aaronjonesii/CustomKeyboard/README.md

# CustomKeyboard
 Full Custom Mechanical Keyboard
