aaronjonesii/CustomKeyboard/KeyboardPCB/keyboard-layout.png

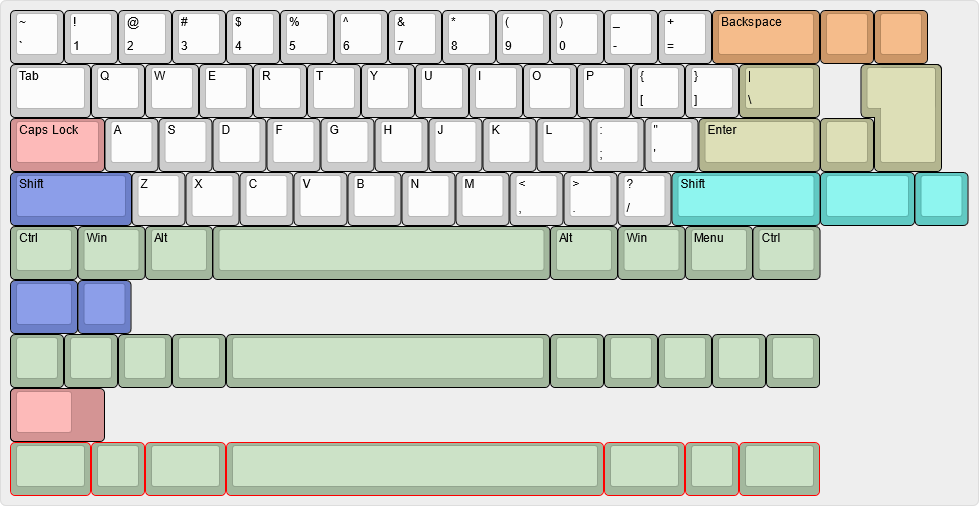
KeyboardPCB/keyboard-layout.png
