aaronjonesii/CustomKeyboard/KeyboardPCB/BOM.xlsx

Item | Value | Size/Package | Notes | Qty | Cost | Total | Web Link
Capacitor | 22pf | 0805 |  | 2 | 0.86 | 1.72 | https://www.aliexpress.com/item/32964553793.html?spm=a2g0s.9042311.0.0.27424c4dyS5jqW
Capacitor | 0.1uf or 100nf | 0805 |  | 4 | 0.0065 | 0.026 | https://lcsc.com/product-detail/Multilayer-Ceramic-Capacitors-MLCC-SMD-SMT_YAGEO-CC0805KRX7R9BB104_C49678.html
Capacitor | 4.7uf | 0805 |  | 1 | 0.0183 | 0.0183 | https://lcsc.com/product-detail/Multilayer-Ceramic-Capacitors-MLCC-SMD-SMT_Samsung-Electro-Mechanics-CL21A475KAQNNNE_C1779.html
Capacitor | 1uf | 0805 |  | 1 | 0.0183 | 0.0183 | https://lcsc.com/product-detail/Multilayer-Ceramic-Capacitors-MLCC-SMD-SMT_FH-Guangdong-Fenghua-Advanced-Tech-0805B105K500NT_C215803.html
Diode |  | 0805 |  | 67 | 2.06 | 138.02 | https://www.aliexpress.com/item/200PCS-1N4148-1N4148WS-T4-1N4148W-SMD-0805-SOD-323-IN4148-0805-SOD323-Switching-Diode-new-and/32774047563.html
Polyfuse | 6v 1a | 0805 |  | 1 | 0.0662 | 0.0662 | https://lcsc.com/product-detail/Resettable-Fuses_TLC-Electronic-TLC-PSMD050_C261942.html
USB Port | Type-C Receptacle |  |  | 1 | 0.2453 | 0.2453 | https://lcsc.com/product-detail/USB-Connectors_Korean-Hroparts-Elec-TYPE-C-31-M-12_C165948.html
JST Header | 4-pin |  |  | 1 | 0.1696 | 0.1696 | https://lcsc.com/product-detail/Wire-To-Board-Wire-To-Wire-Connector_JST-Sales-America-SM04B-SRSS-TB-LF-SN_C160404.html
Resistor | 10k | 0805 |  | 2 | 0.0028 | 0.0056 | https://lcsc.com/product-detail/Chip-Resistor-Surface-Mount_RALEC-RTT051002FTP_C103904.html
Resistor | 5.1k | 0805 |  | 2 | 0.0053 | 0.0106 | https://lcsc.com/product-detail/Chip-Resistor-Surface-Mount_TA-I-Tech-RMS10FT5101_C212411.html
Resistor | 22ohms | 0805 |  | 2 | 0.0054 | 0.0108 | https://lcsc.com/product-detail/Chip-Resistor-Surface-Mount_TyoHM-RMC0805221-N_C325772.html
MCU | ATmega32U4-AU | QFP-44_10mmx10mm |  | 1 | 2.7 | 2.7 | https://www.aliexpress.com/item/32983202162.html?spm=a2g0s.9042311.0.0.27424c4dyS5jqW
ESD | USBLC6-2SC6 | SOT23-6 or SOT-23-6 |  | 1 | 0.94 | 0.94 | https://www.aliexpress.com/item/10PCS-USBLC6-2SC6-SOT23-6-USBLC6-SOT-UL26-SOT23-new-and-original-IC/32964509708.html
Crystal | 16MHz | SMD3225-4P |  | 1 | 0.1056 | 0.1056 | https://lcsc.com/product-detail/Crystals_JYJE-3TJ416000XYGBC_C2149027.html
