aaronjonesii/CustomKeyboard/KeyboardPCB/AnonymousKeyboard_Rev0.kicad_pcb

## KiCad design KeyboardPCB/AnonymousKeyboard_Rev0.kicad_pcb (2021-08-27)

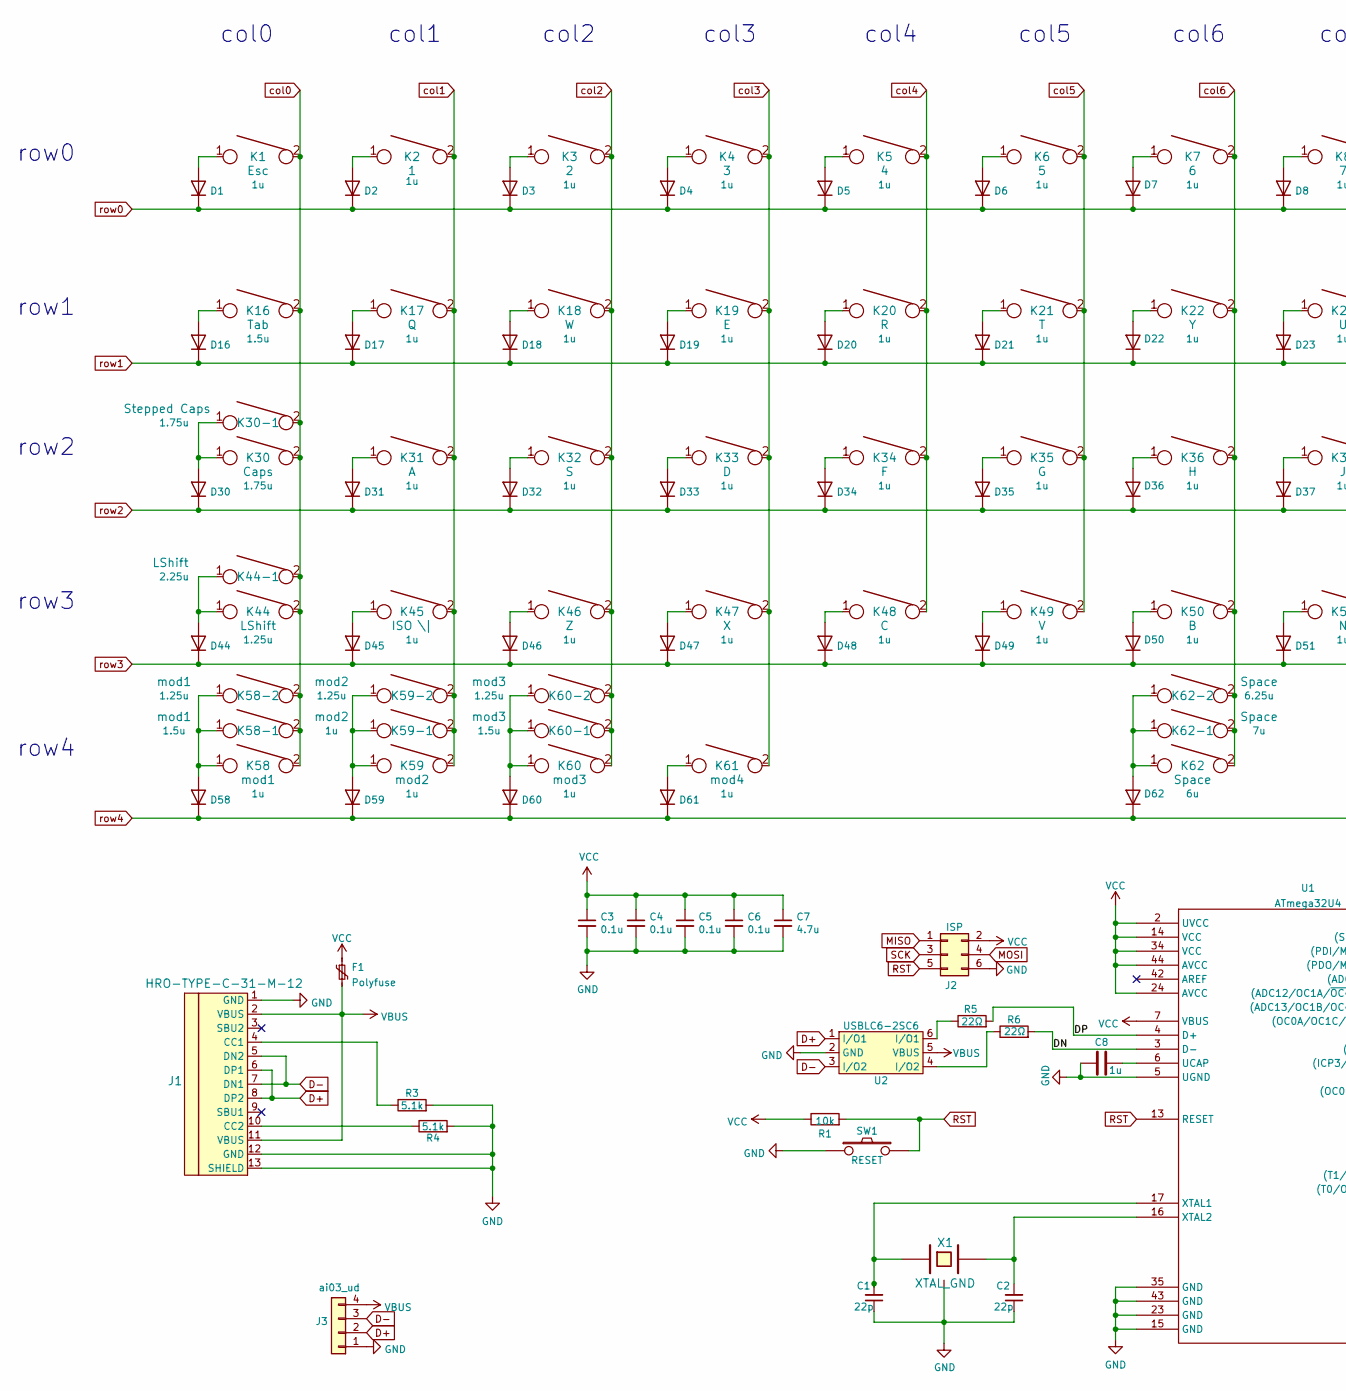
[picture p2: schematic AnonymousKeyboard_Rev0.kicad_sch, Anonymous Keyboard - Schematic, part in row 1, column 1]

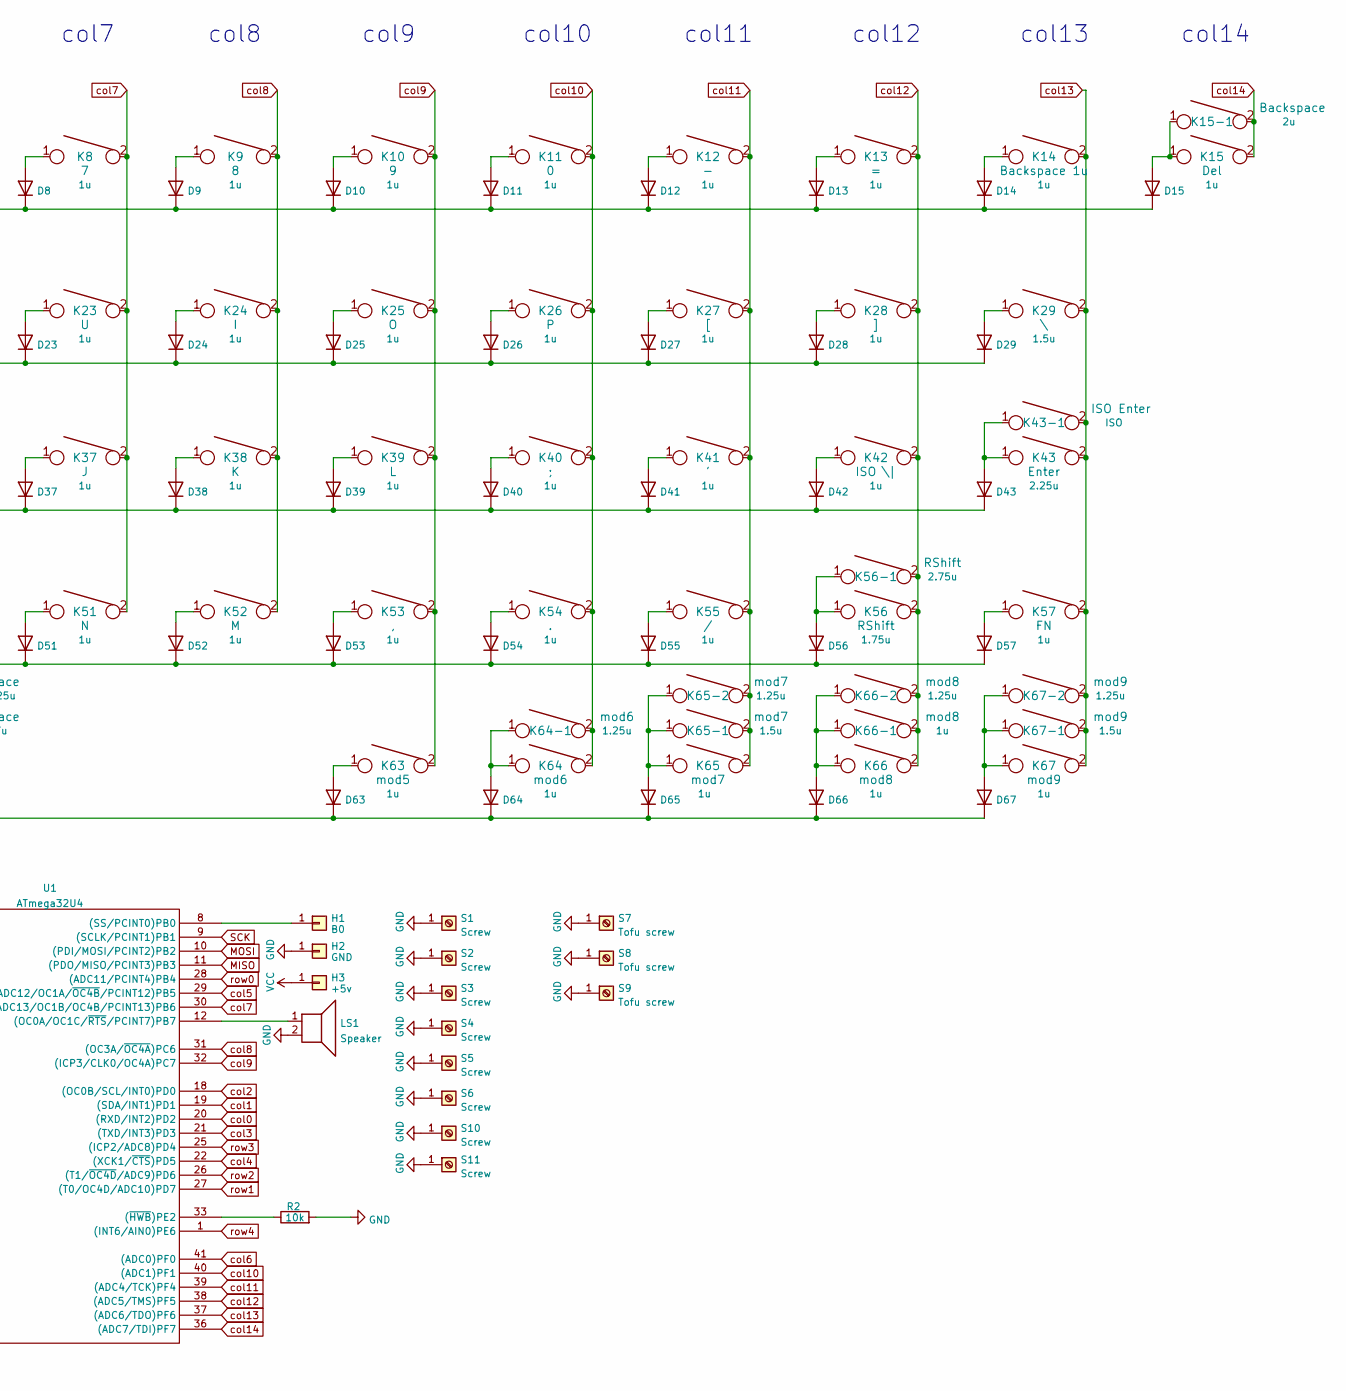
[picture p3: schematic AnonymousKeyboard_Rev0.kicad_sch, Anonymous Keyboard - Schematic, part in row 1, column 2]

Parts:
C1, C2: 22p; C_0805_2012Metric_Pad1.18x1.45mm_HandSolder
C3, C4, C5, C6: 0.1u; C_0805_2012Metric_Pad1.18x1.45mm_HandSolder
C7: 4.7u; C_0805_2012Metric_Pad1.18x1.45mm_HandSolder
C8: 1u; C_0805_2012Metric_Pad1.18x1.45mm_HandSolder
D1, D2, D3, D4, D5, D6, D7, D8, D9, D10, D11, D12, D13, D14, D15, D16, D17, D18, D19, D20, D21, D22, D23, D24, D25, D26, D27, D28, D29, D30, D31, D32, D33, D34, D35, D36, D37, D38, D39, D40, D41, D42, D43, D44, D45, D46, D47, D48, D49, D50, D51, D52, D53, D54, D55, D56, D57, D58, D59, D60, D61, D62, D63, D64, D65, D66, D67: D; D_0805_2012Metric_Pad1.15x1.40mm_HandSolder
F1: Polyfuse; R_0805_2012Metric_Pad1.20x1.40mm_HandSolder
H1: B0; free_pin
H2: GND; free_pin
H3: +5v; free_pin
J1: HRO-TYPE-C-31-M-12; HRO-TYPE-C-31-M-12-Assembly
J2: ISP; AVR_ICSP_3x2
J3: ai03_ud; JST_SH_SM04B-SRSS-TB_1x04-1MP_P1.00mm_Horizontal
K1: Esc; MXOnly-1U-NoLED
K2: 1; MXOnly-1U-NoLED
K3: 2; MXOnly-1U-NoLED
K4: 3; MXOnly-1U-NoLED
K5: 4; MXOnly-1U-NoLED
K6: 5; MXOnly-1U-NoLED
K7: 6; MXOnly-1U-NoLED
K8: 7; MXOnly-1U-NoLED
K9: 8; MXOnly-1U-NoLED
K10: 9; MXOnly-1U-NoLED
K11: 0; MXOnly-1U-NoLED
K12: -; MXOnly-1U-NoLED
K13: =; MXOnly-1U-NoLED
K14: Backspace 1u; MXOnly-1U-NoLED
K15: Del; MXOnly-1U-NoLED
K15-1: Backspace; MXOnly-2U-NoLED
K16: Tab; MXOnly-1.5U-NoLED
K17: Q; MXOnly-1U-NoLED
K18: W; MXOnly-1U-NoLED
K19: E; MXOnly-1U-NoLED
K20: R; MXOnly-1U-NoLED
K21: T; MXOnly-1U-NoLED
K22: Y; MXOnly-1U-NoLED
K23: U; MXOnly-1U-NoLED
K24: I; MXOnly-1U-NoLED
K25: O; MXOnly-1U-NoLED
K26: P; MXOnly-1U-NoLED
K27: [; MXOnly-1U-NoLED
K28: ]; MXOnly-1U-NoLED
K29: \; MXOnly-1.5U-NoLED
K30: Caps; MXOnly-1.75U-NoLED
K30-1: Stepped Caps; MXOnly-1.25U-NoLED
K31: A; MXOnly-1U-NoLED
K32: S; MXOnly-1U-NoLED
K33: D; MXOnly-1U-NoLED
K34: F; MXOnly-1U-NoLED
K35: G; MXOnly-1U-NoLED
K36: H; MXOnly-1U-NoLED
K37: J; MXOnly-1U-NoLED
K38: K; MXOnly-1U-NoLED
K39: L; MXOnly-1U-NoLED
K40: ;; MXOnly-1U-NoLED
K41: '; MXOnly-1U-NoLED
K42, K45: ISO \|; MXOnly-1U-NoLED
K43: Enter; MXOnly-2.25U-NoLED
K43-1: ISO Enter; MXOnly-ISO-NoLED
K44: LShift; MXOnly-1.25U-NoLED
K44-1: LShift; MXOnly-2.25U-NoLED
K46: Z; MXOnly-1U-NoLED
K47: X; MXOnly-1U-NoLED
K48: C; MXOnly-1U-NoLED
K49: V; MXOnly-1U-NoLED
K50: B; MXOnly-1U-NoLED
K51: N; MXOnly-1U-NoLED
K52: M; MXOnly-1U-NoLED
K53: ,; MXOnly-1U-NoLED
K54: .; MXOnly-1U-NoLED
K55: /; MXOnly-1U-NoLED
K56: RShift; MXOnly-1.75U-NoLED
K56-1: RShift; MXOnly-2.75U-NoLED
K57: FN; MXOnly-1U-NoLED
K58: mod1; MXOnly-1U-NoLED
K58-1: mod1; MXOnly-1.5U-NoLED
K58-2: mod1; MXOnly-1.25U-NoLED
K59, K59-1: mod2; MXOnly-1U-NoLED
K59-2: mod2; MXOnly-1.25U-NoLED
K60: mod3; MXOnly-1U-NoLED
K60-1: mod3; MXOnly-1.5U-NoLED
K60-2: mod3; MXOnly-1.25U-NoLED
K61: mod4; MXOnly-1U-NoLED
K62: Space; MXOnly-6U-Centered-NoLED
K62-1: Space; MXOnly-7U-NoLED
K62-2: Space; MXOnly-6.25U-NoLED
K63: mod5; MXOnly-1U-NoLED
K64: mod6; MXOnly-1U-NoLED
K64-1: mod6; MXOnly-1.25U-NoLED
K65: mod7; MXOnly-1U-NoLED
K65-1: mod7; MXOnly-1.5U-NoLED
K65-2: mod7; MXOnly-1.25U-NoLED
K66, K66-1: mod8; MXOnly-1U-NoLED
K66-2: mod8; MXOnly-1.25U-NoLED
K67: mod9; MXOnly-1U-NoLED
K67-1: mod9; MXOnly-1.5U-NoLED
K67-2: mod9; MXOnly-1.25U-NoLED
LS1: Speaker; AST1109MLTRQ
R1, R2: 10k; R_0805
R3, R4: 5.1k; R_0805
R5, R6: 22Ω; R_0805
S1, S2, S4, S6, S10, S11: Screw; 5.5_5x2.5mm
S3, S5: Screw; 10x5_7x2.5mm
S7, S8, S9: Tofu screw; 5.5_5x2.5mm
SW1: RESET; ResetPins
U1: ATmega32U4; ATMEGA32U4-AU
U2: USBLC6-2SC6; TSOT-23-6_HandSoldering; Farnell 1295310
X1: XTAL_GND; FA-238

Connections:
/DN: R6.2, U1.3 (D-)
/DP: R5.2, U1.4 (D+)
D+: J1.6 (DP1), J1.8 (DP2), J3.2, U2.1 (I/O1)
D-: J1.5 (DN2), J1.7 (DN1), J3.3, U2.3 (I/O2)
GND: C1.1, C2.1, C3.2, C4.2, C5.2, C6.2, C7.2, C8.2, H2.1, J1.1 (GND), J1.12 (GND), J1.13 (SHIELD), J2.6, J3.1, LS1.2, R2.2, R3.2, R4.2, S1.1, S2.1, S3.1, S4.1, S5.1, S6.1, S7.1, S8.1, S9.1, S10.1, S11.1, SW1.1, U1.5 (UGND), U1.15 (GND), U1.23 (GND), U1.35 (GND), U1.43 (GND), U2.2 (GND), X1.3
MISO: J2.1, U1.11 ((PDO/MISO/PCINT3)PB3)
MOSI: J2.4, U1.10 ((PDI/MOSI/PCINT2)PB2)
unnamed: C1.2, U1.17 (XTAL1), X1.1
unnamed: C2.2, U1.16 (XTAL2), X1.2
unnamed: C8.1, U1.6 (UCAP)
unnamed: D1.2 (A), K1.1
unnamed: D2.2 (A), K2.1
unnamed: D3.2 (A), K3.1
unnamed: D4.2 (A), K4.1
unnamed: D5.2 (A), K5.1
unnamed: D6.2 (A), K6.1
unnamed: D7.2 (A), K7.1
unnamed: D8.2 (A), K8.1
unnamed: D9.2 (A), K9.1
unnamed: D10.2 (A), K10.1
unnamed: D11.2 (A), K11.1
unnamed: D12.2 (A), K12.1
unnamed: D13.2 (A), K13.1
unnamed: D14.2 (A), K14.1
unnamed: D15.2 (A), K15.1, K15-1.1
unnamed: D16.2 (A), K16.1
unnamed: D17.2 (A), K17.1
unnamed: D18.2 (A), K18.1
unnamed: D19.2 (A), K19.1
unnamed: D20.2 (A), K20.1
unnamed: D21.2 (A), K21.1
unnamed: D22.2 (A), K22.1
unnamed: D23.2 (A), K23.1
unnamed: D24.2 (A), K24.1
unnamed: D25.2 (A), K25.1
unnamed: D26.2 (A), K26.1
unnamed: D27.2 (A), K27.1
unnamed: D28.2 (A), K28.1
unnamed: D29.2 (A), K29.1
unnamed: D30.2 (A), K30.1, K30-1.1
unnamed: D31.2 (A), K31.1
unnamed: D32.2 (A), K32.1
unnamed: D33.2 (A), K33.1
unnamed: D34.2 (A), K34.1
unnamed: D35.2 (A), K35.1
unnamed: D36.2 (A), K36.1
unnamed: D37.2 (A), K37.1
unnamed: D38.2 (A), K38.1
unnamed: D39.2 (A), K39.1
unnamed: D40.2 (A), K40.1
unnamed: D41.2 (A), K41.1
unnamed: D42.2 (A), K42.1
unnamed: D43.2 (A), K43.1, K43-1.1
unnamed: D44.2 (A), K44.1, K44-1.1
unnamed: D45.2 (A), K45.1
unnamed: D46.2 (A), K46.1
unnamed: D47.2 (A), K47.1
unnamed: D48.2 (A), K48.1
unnamed: D49.2 (A), K49.1
unnamed: D50.2 (A), K50.1
unnamed: D51.2 (A), K51.1
unnamed: D52.2 (A), K52.1
unnamed: D53.2 (A), K53.1
unnamed: D54.2 (A), K54.1
unnamed: D55.2 (A), K55.1
unnamed: D56.2 (A), K56.1, K56-1.1
unnamed: D57.2 (A), K57.1
unnamed: D58.2 (A), K58.1, K58-1.1, K58-2.1
unnamed: D59.2 (A), K59.1, K59-1.1, K59-2.1
unnamed: D60.2 (A), K60.1, K60-1.1, K60-2.1
unnamed: D61.2 (A), K61.1
unnamed: D62.2 (A), K62.1, K62-1.1, K62-2.1
unnamed: D63.2 (A), K63.1
unnamed: D64.2 (A), K64.1, K64-1.1
unnamed: D65.2 (A), K65.1, K65-1.1, K65-2.1
unnamed: D66.2 (A), K66.1, K66-1.1, K66-2.1
unnamed: D67.2 (A), K67.1, K67-1.1, K67-2.1
unnamed: H1.1, U1.8 ((SS/PCINT0)PB0)
unnamed: J1.4 (CC1), R3.1
unnamed: J1.10 (CC2), R4.1
unnamed: LS1.1, U1.12 ((OC0A/OC1C/~RTS/PCINT7)PB7)
unnamed: R2.1, U1.33 ((~HWB)PE2)
unnamed: R5.1, U2.6 (I/O1)
unnamed: R6.1, U2.4 (I/O2)
RST: J2.5, R1.2, SW1.2, U1.13 (RESET)
SCK: J2.3, U1.9 ((SCLK/PCINT1)PB1)
VBUS: F1.2, J1.2 (VBUS), J1.11 (VBUS), J3.4, U2.5 (VBUS)
VCC: C3.1, C4.1, C5.1, C6.1, C7.1, F1.1, H3.1, J2.2, R1.1, U1.2 (UVCC), U1.7 (VBUS), U1.14 (VCC), U1.24 (AVCC), U1.34 (VCC), U1.44 (AVCC)
col0: K1.2, K16.2, K30.2, K30-1.2, K44.2, K44-1.2, K58.2, K58-1.2, K58-2.2, U1.20 ((RXD/INT2)PD2)
col1: K2.2, K17.2, K31.2, K45.2, K59.2, K59-1.2, K59-2.2, U1.19 ((SDA/INT1)PD1)
col2: K3.2, K18.2, K32.2, K46.2, K60.2, K60-1.2, K60-2.2, U1.18 ((OC0B/SCL/INT0)PD0)
col3: K4.2, K19.2, K33.2, K47.2, K61.2, U1.21 ((TXD/INT3)PD3)
col4: K5.2, K20.2, K34.2, K48.2, U1.22 ((XCK1/~CTS)PD5)
col5: K6.2, K21.2, K35.2, K49.2, U1.29 ((ADC12/OC1A/~OC4B/PCINT12)PB5)
col6: K7.2, K22.2, K36.2, K50.2, K62.2, K62-1.2, K62-2.2, U1.41 ((ADC0)PF0)
col7: K8.2, K23.2, K37.2, K51.2, U1.30 ((ADC13/OC1B/OC4B/PCINT13)PB6)
col8: K9.2, K24.2, K38.2, K52.2, U1.31 ((OC3A/~OC4A)PC6)
col9: K10.2, K25.2, K39.2, K53.2, K63.2, U1.32 ((ICP3/CLK0/OC4A)PC7)
col10: K11.2, K26.2, K40.2, K54.2, K64.2, K64-1.2, U1.40 ((ADC1)PF1)
col11: K12.2, K27.2, K41.2, K55.2, K65.2, K65-1.2, K65-2.2, U1.39 ((ADC4/TCK)PF4)
col12: K13.2, K28.2, K42.2, K56.2, K56-1.2, K66.2, K66-1.2, K66-2.2, U1.38 ((ADC5/TMS)PF5)
col13: K14.2, K29.2, K43.2, K43-1.2, K57.2, K67.2, K67-1.2, K67-2.2, U1.37 ((ADC6/TDO)PF6)
col14: K15.2, K15-1.2, U1.36 ((ADC7/TDI)PF7)
row0: D1.1 (K), D2.1 (K), D3.1 (K), D4.1 (K), D5.1 (K), D6.1 (K), D7.1 (K), D8.1 (K), D9.1 (K), D10.1 (K), D11.1 (K), D12.1 (K), D13.1 (K), D14.1 (K), D15.1 (K), U1.28 ((ADC11/PCINT4)PB4)
row1: D16.1 (K), D17.1 (K), D18.1 (K), D19.1 (K), D20.1 (K), D21.1 (K), D22.1 (K), D23.1 (K), D24.1 (K), D25.1 (K), D26.1 (K), D27.1 (K), D28.1 (K), D29.1 (K), U1.27 ((T0/OC4D/ADC10)PD7)
row2: D30.1 (K), D31.1 (K), D32.1 (K), D33.1 (K), D34.1 (K), D35.1 (K), D36.1 (K), D37.1 (K), D38.1 (K), D39.1 (K), D40.1 (K), D41.1 (K), D42.1 (K), D43.1 (K), U1.26 ((T1/~OC4D/ADC9)PD6)
row3: D44.1 (K), D45.1 (K), D46.1 (K), D47.1 (K), D48.1 (K), D49.1 (K), D50.1 (K), D51.1 (K), D52.1 (K), D53.1 (K), D54.1 (K), D55.1 (K), D56.1 (K), D57.1 (K), U1.25 ((ICP2/ADC8)PD4)
row4: D58.1 (K), D59.1 (K), D60.1 (K), D61.1 (K), D62.1 (K), D63.1 (K), D64.1 (K), D65.1 (K), D66.1 (K), D67.1 (K), U1.1 ((INT6/AIN0)PE6)

Notes on the sheet:
row0
row1
row2
row3
row4
col0
col1
col2
col3
col4
col5
col6
col7
col8
col9
col10
col11
col12
col13
col14

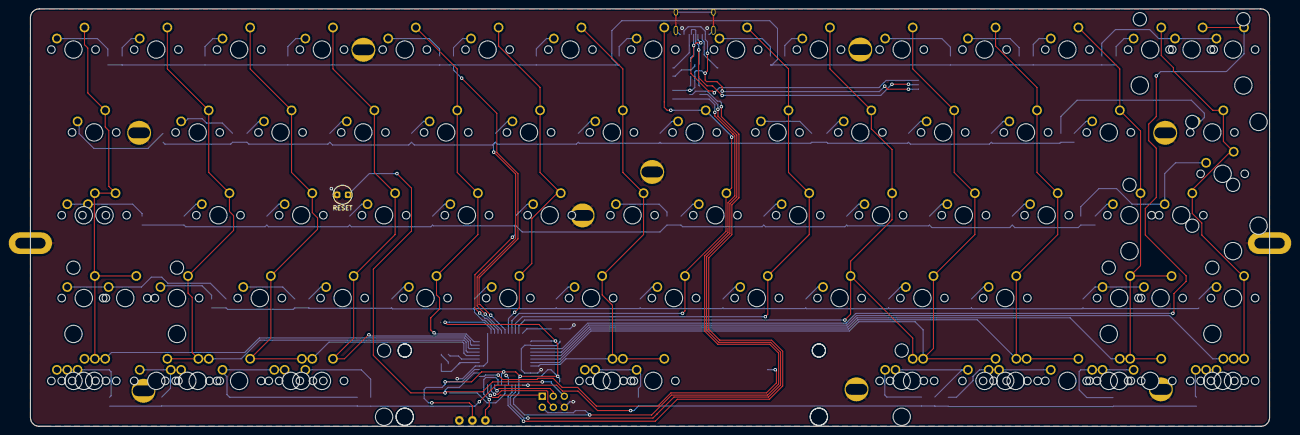
[picture p4: board AnonymousKeyboard_Rev0.kicad_pcb from above]

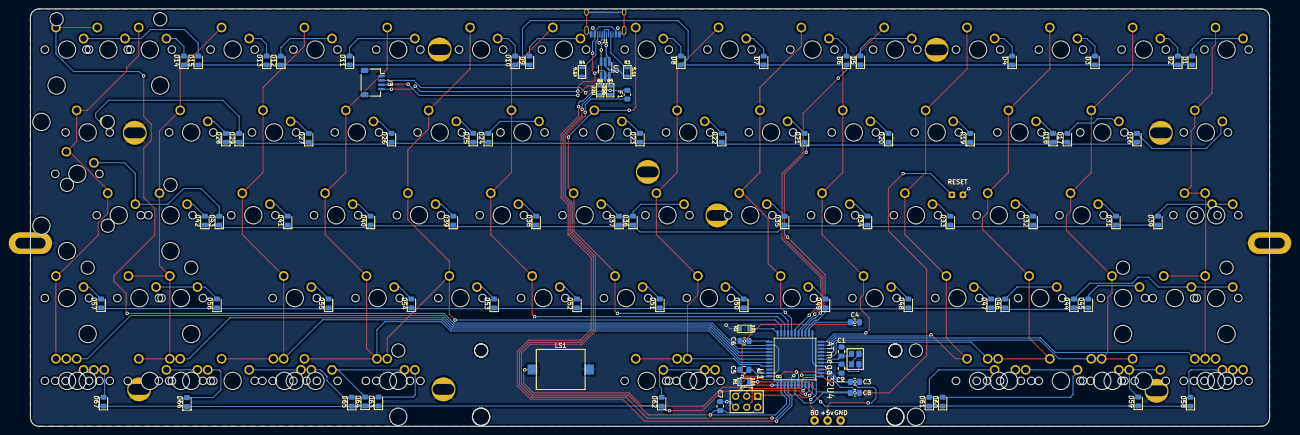
[picture p5: board AnonymousKeyboard_Rev0.kicad_pcb from below]

Board: 2 copper layers, 285.0 x 96.0 mm, 191 parts (89 on the bottom side), 108 nets.
